satyaidk/ovo/firmware/MochiEyes/secrets.example.h

// Template. Copy to secrets.h (git-ignored) and fill in your network.
// Without secrets.h the device opens the AP_SSID hotspot instead.
#pragma once

#define WIFI_SSID_DEFAULT "YOUR_WIFI_NAME"       // 2.4 GHz only
#define WIFI_PASS_DEFAULT "YOUR_WIFI_PASSWORD"

#define AP_SSID "Kitty"
#define AP_PASS "12345678"                        // at least 8 characters
